ibraheemsyed-sys/OpenTransformer/reports/openroad/pe_array_final/reports/cts_default_clk.webp

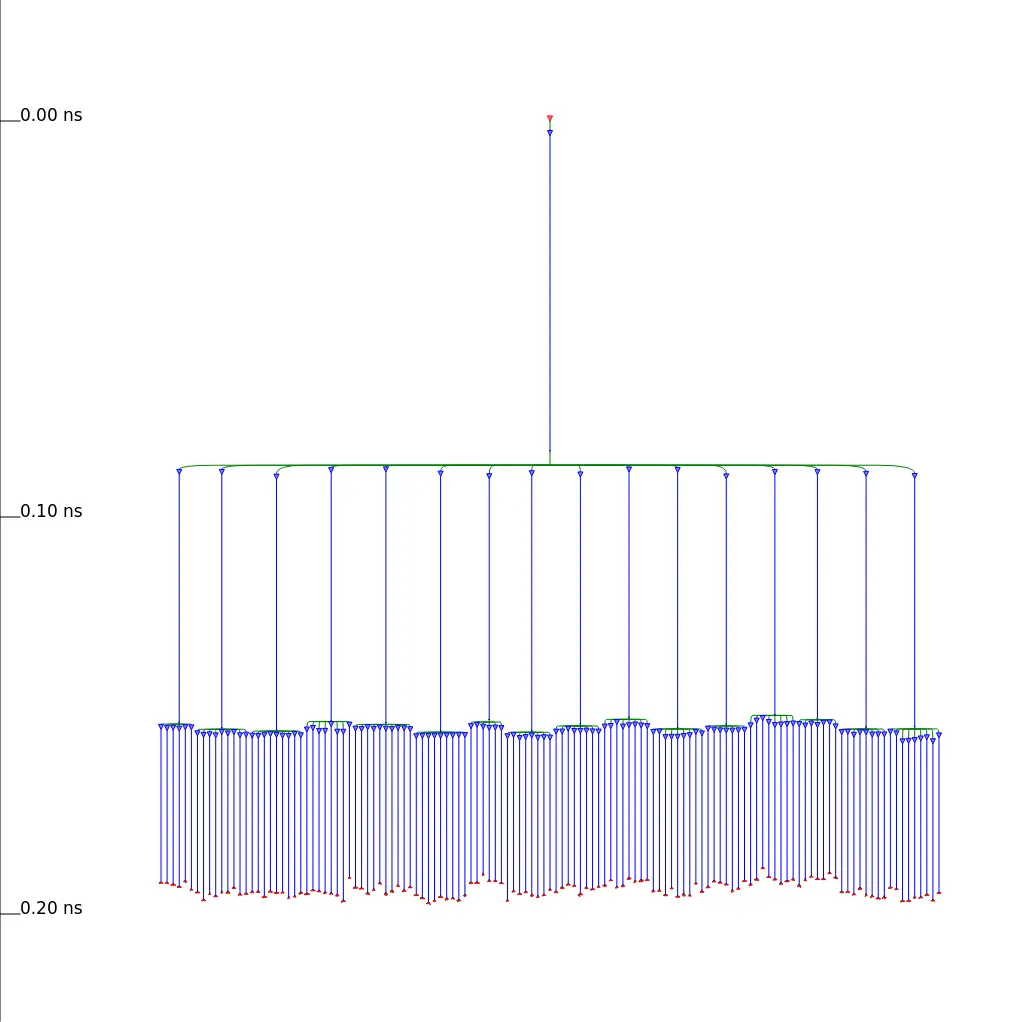
reports/openroad/pe_array_final/reports/cts_default_clk.webp
