ibraheemsyed-sys/OpenTransformer/reports/openroad/pe_array_final/reports/cts_default_clk_layout.webp

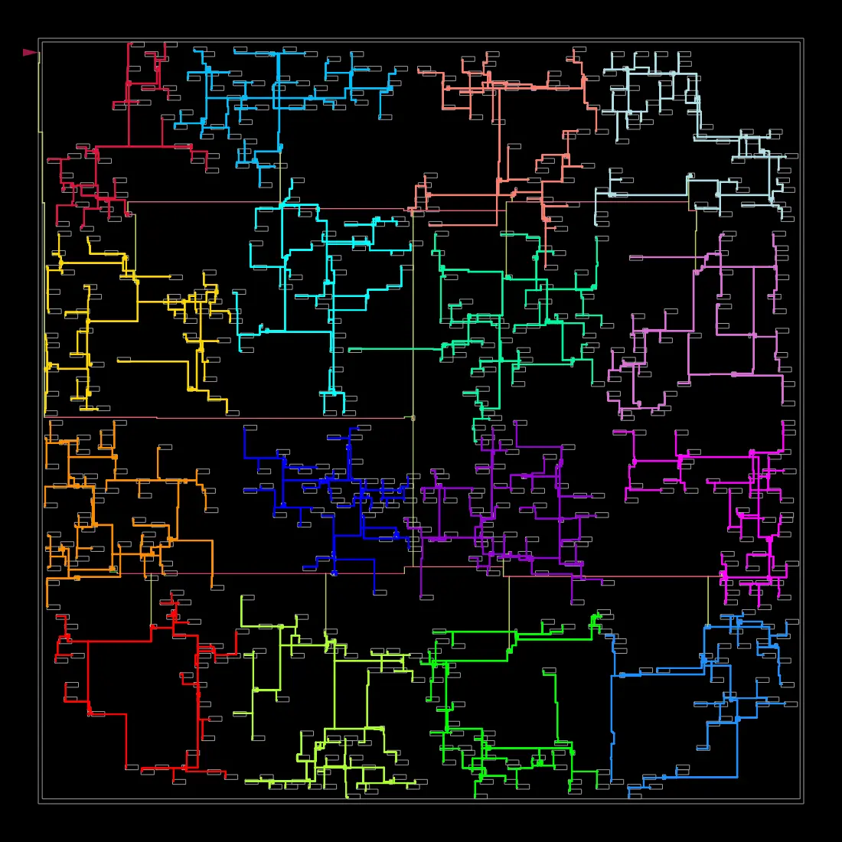
reports/openroad/pe_array_final/reports/cts_default_clk_layout.webp
