ibraheemsyed-sys/OpenTransformer/reports/openroad/pe_array_final/reports/final_clocks.webp

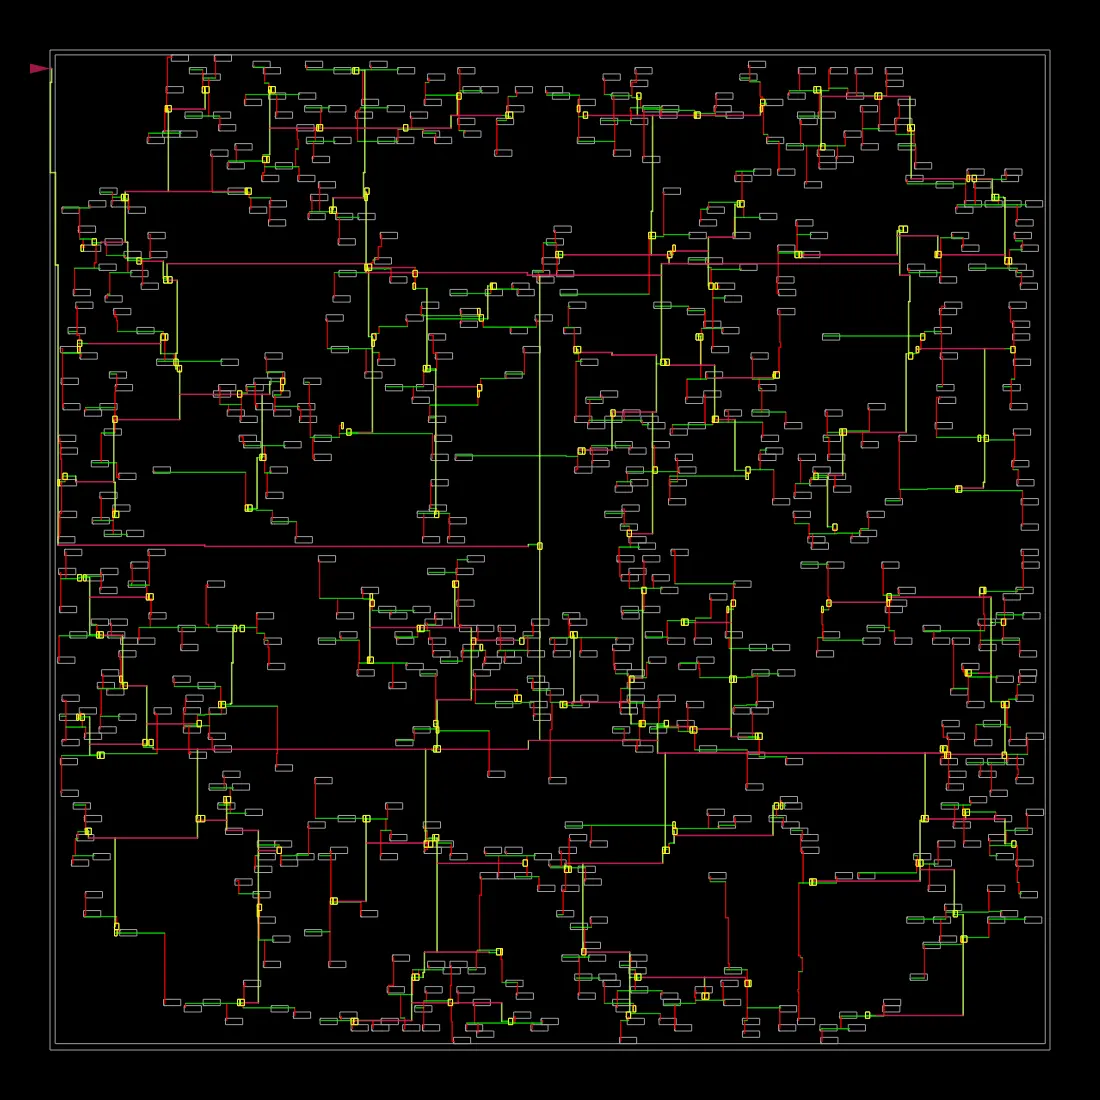
reports/openroad/pe_array_final/reports/final_clocks.webp
