ibraheemsyed-sys/OpenTransformer/reports/openroad/pe_array_final/reports/final_congestion.webp

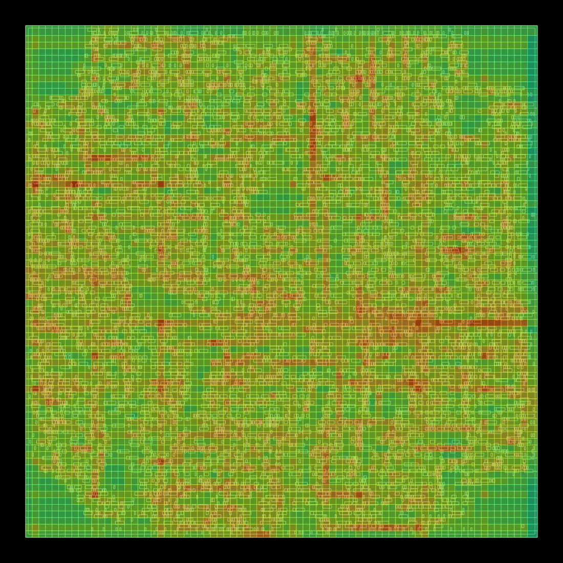
reports/openroad/pe_array_final/reports/final_congestion.webp
