ibraheemsyed-sys/OpenTransformer/reports/openroad/pe_array_final/reports/final_ir_drop.webp

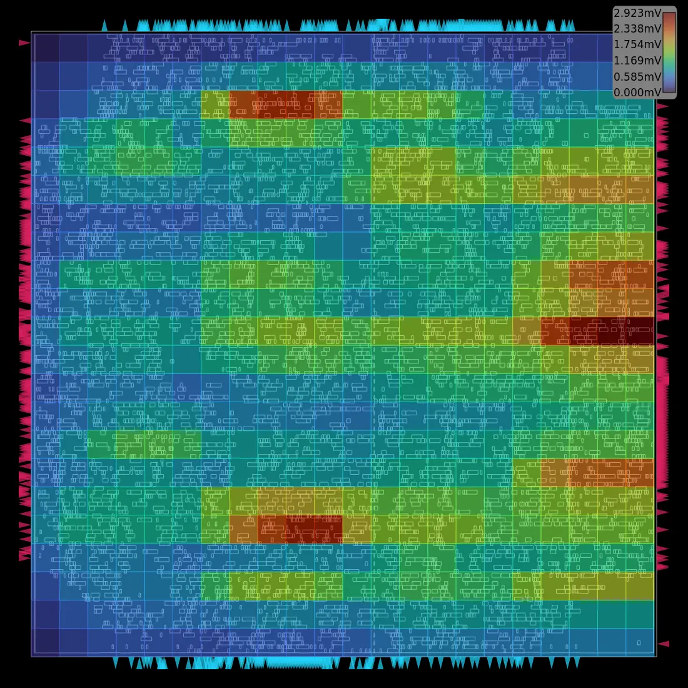
reports/openroad/pe_array_final/reports/final_ir_drop.webp
