ibraheemsyed-sys/OpenTransformer/reports/openroad/pe_array_final/reports/final_placement.webp

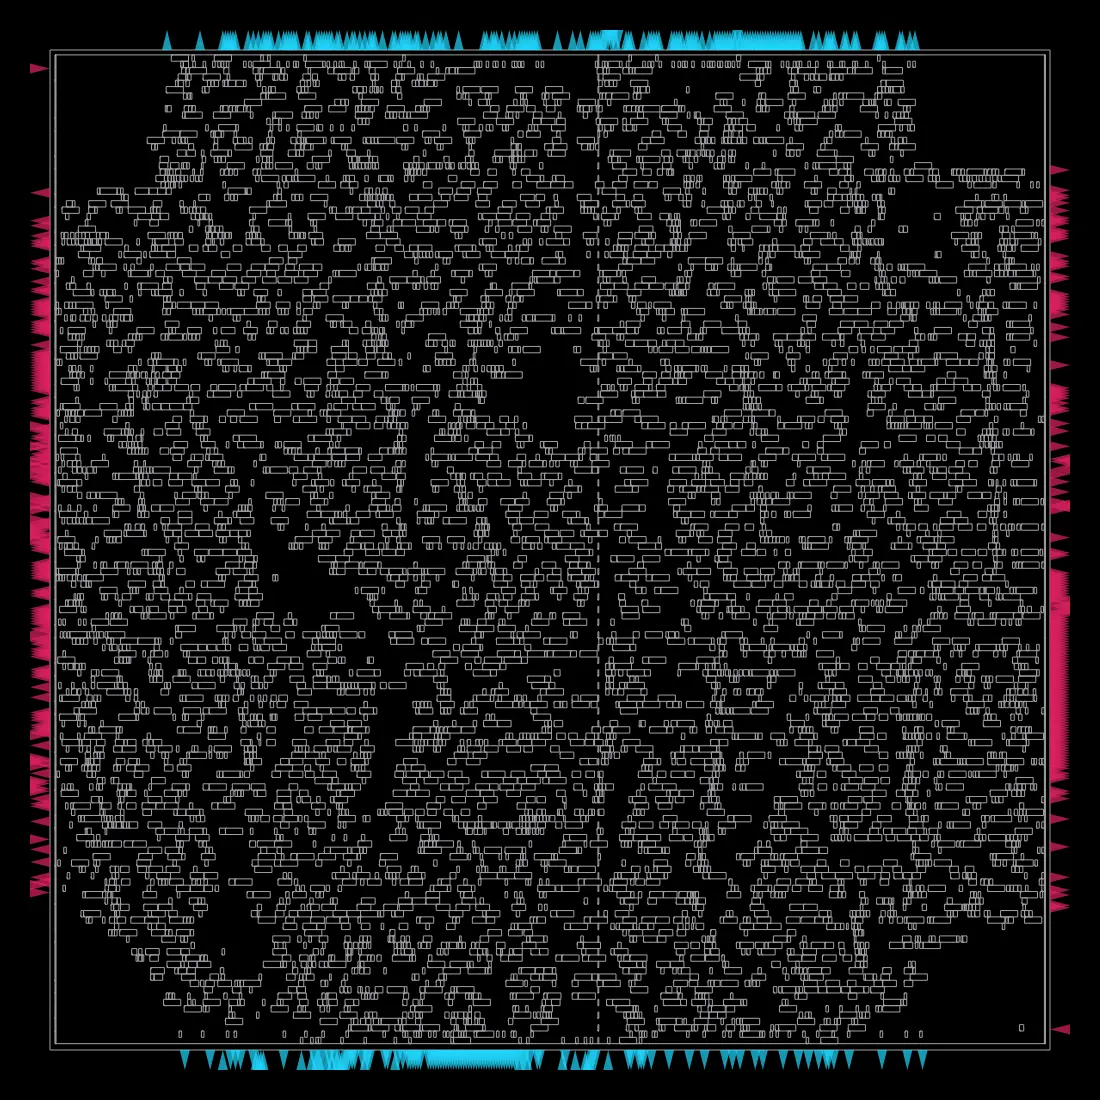
reports/openroad/pe_array_final/reports/final_placement.webp
