ibraheemsyed-sys/OpenTransformer/reports/openroad/pe_array_final/reports/final_resizer.webp

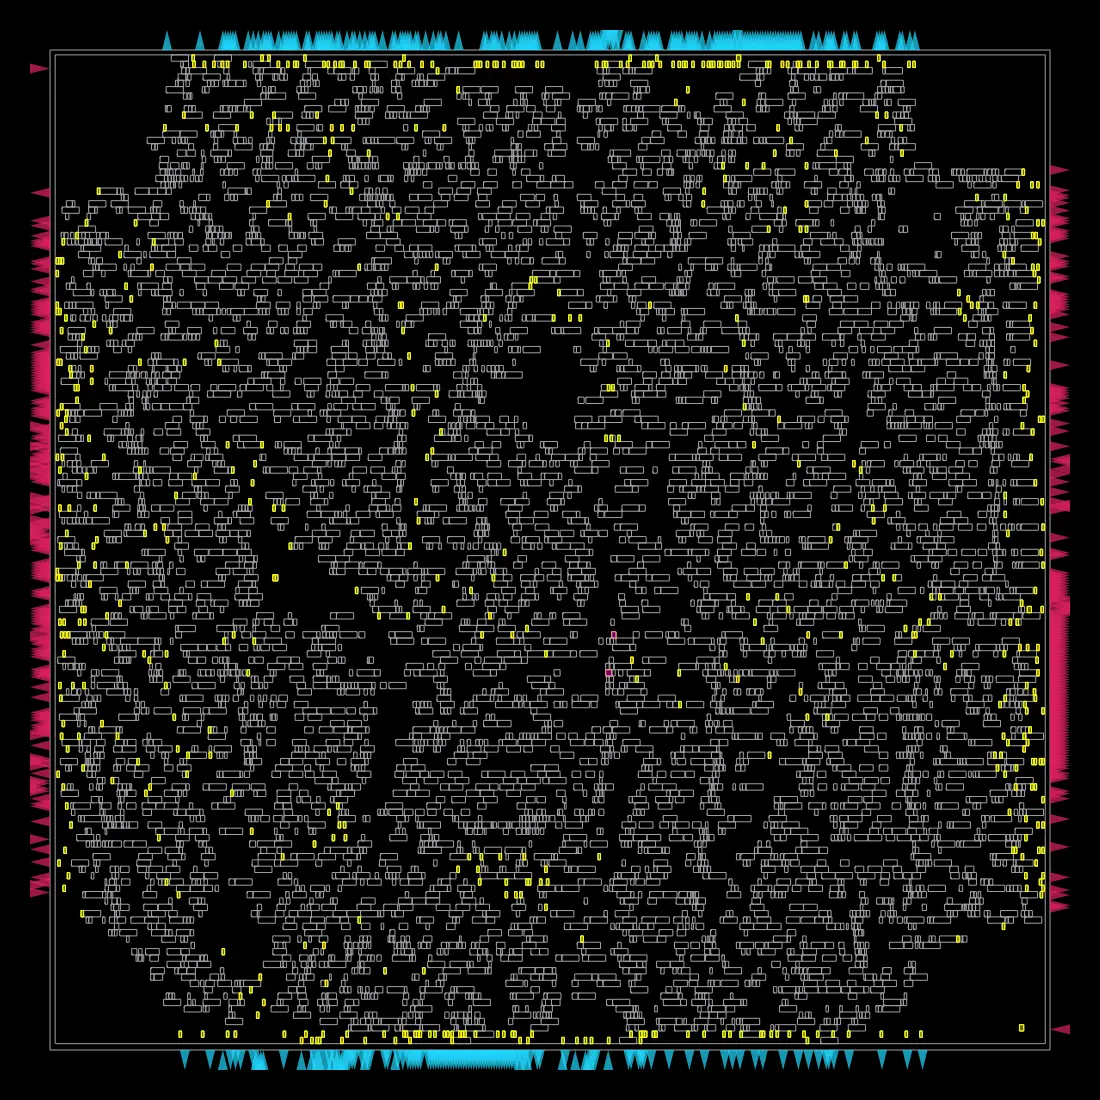
reports/openroad/pe_array_final/reports/final_resizer.webp
