ibraheemsyed-sys/OpenTransformer/reports/openroad/pe_array_final/reports/final_routing.webp

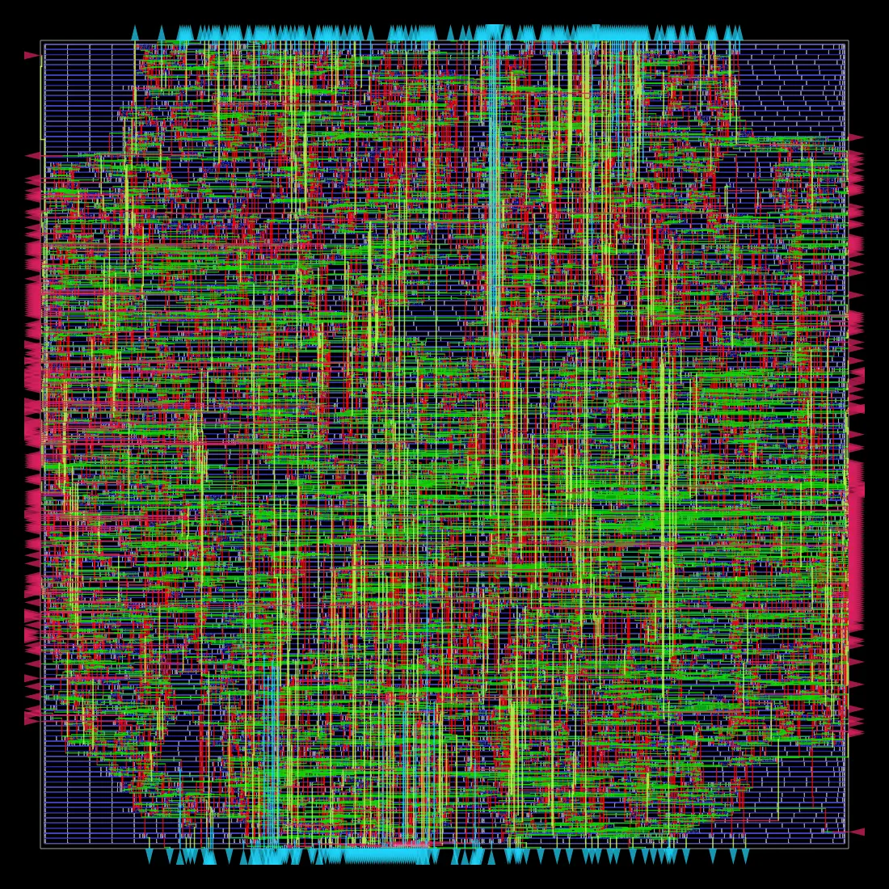
reports/openroad/pe_array_final/reports/final_routing.webp
