ibraheemsyed-sys/OpenTransformer/reports/openroad/pe_array_final/reports/final_worst_path.webp

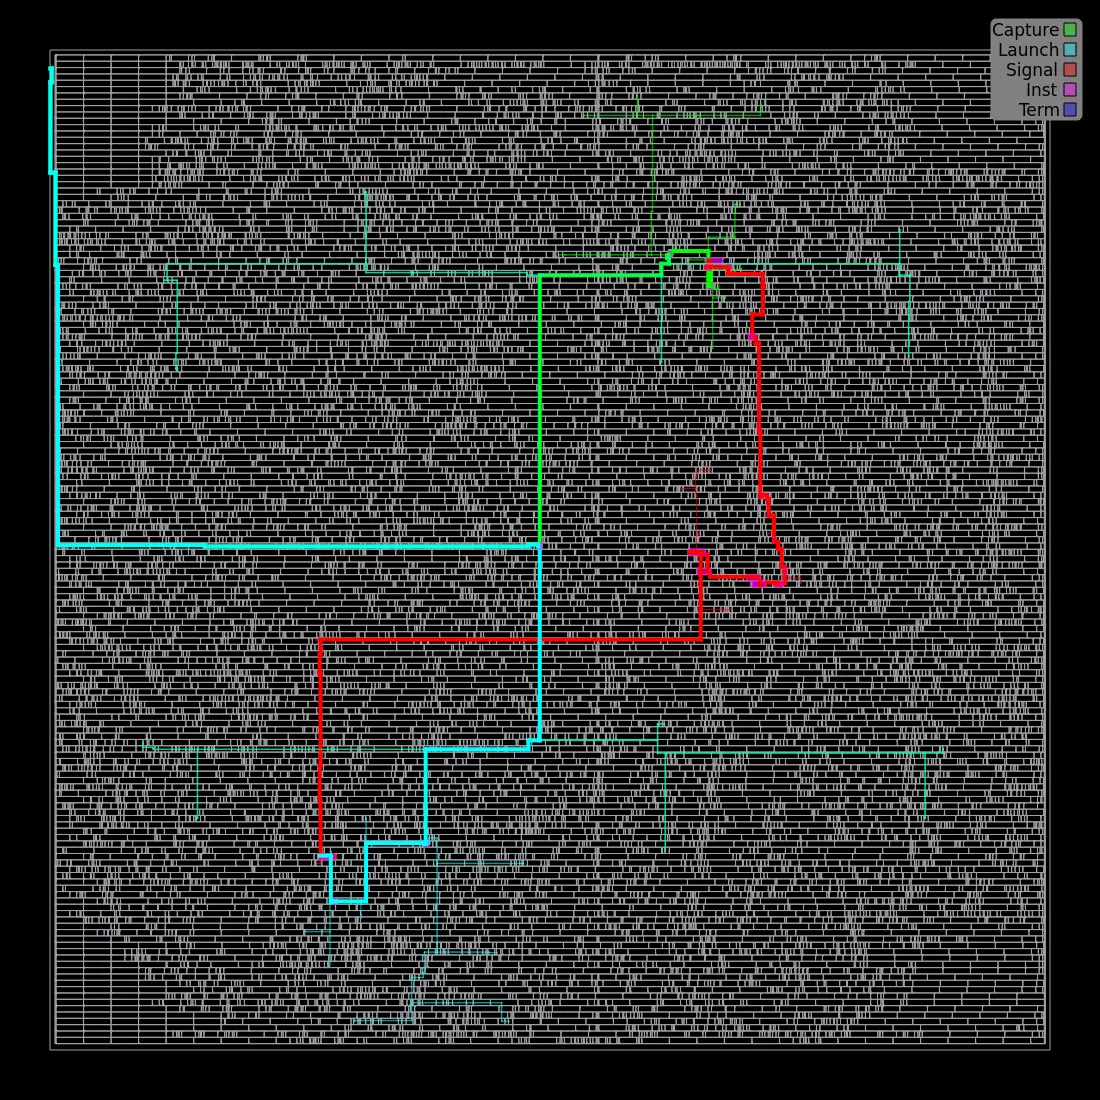
reports/openroad/pe_array_final/reports/final_worst_path.webp
