ibraheemsyed-sys/OpenTransformer/tb/tb_and_gate.sv

module tb_and_gate;

    logic a;
    logic b;
    logic y;

    and_gate utt(
        .a(a),
        .b(b),
        .y(y)
    );

    initial begin
        $dumpfile("and_gate.vcd");
        $dumpvars(0, tb_and_gate);
        
        $display("Time | A | B | Y");
        $display("-----------------");
        
        a=0; b=0; #10; $display("%0t   | %b | %b | %b", $time, a, b, y);
        a=0; b=1; #10; $display("%0t   | %b | %b | %b", $time, a, b, y);
        a=1; b=0; #10; $display("%0t   | %b | %b | %b", $time, a, b, y);
        a=1; b=1; #10; $display("%0t   | %b | %b | %b", $time, a, b, y);
    end

endmodule
