ibraheemsyed-sys/OpenTransformer/(commit log)

2026-07-04 chore: force track empty weekly infrastructure folders using placeholders
2026-07-05 fix: resolve ALU type errors, compiler warnings, and verify simulation
    [alu_8bit.sv, alu_pkg.sv, tb_alu_8bit.sv]
2026-07-07 Add initial README for OpenTransformer project
    This README introduces the OpenTransformer project, detailing its motivation, current progress, tools used, repository structure, development roadmap, and project goals.
2026-08-02 feat: add VCD dump support to mmu_fsm testbench; docs: add waveform trace and log update
